analogicus/lelo_gr02_sky130a/sim/BANDGAP/README.md

TB_NCM

#### Transient analysis (tran)

Check transient operation

|**Name**|**Parameter**|**Description**| |**Min**|**Typ**|**Max**| Unit|
|:---|:---|:---|---:|:---:|:---:|:---:| ---:|
|**Current proportial to temperature, offset at zero celsius**|**iptat\_intercept** || **Spec**  | **0.050** | **0.000** | **10.000** | **uA** |
| | | |<a href='results/tran_Sch_typical.html'>Sch_typ</a>| | 1.775 |  | |
| | | |<a href='results/tran_Sch_etc.html'>Sch_etc</a>|2.120 | 2.433 | 2.816 | |
| | | |<a href='results/tran_Sch_mc.html'>Sch_3std</a>|0.439 | 2.578 | 4.717 | |
| | | |<a href='results/tran_Lay_typical.html'>Lay_typ</a>| | 2.417 |  | |
| | | |<a href='results/tran_Lay_etc.html'>Lay_etc</a>|2.120 | 2.433 | 2.816 | |
| | | |<a href='results/tran_Lay_mc.html'>Lay_3std</a>|0.073 | 2.616 | 5.159 | |
|**Current proportial to temperature, increase per kelvin**|**iptat\_slope** || **Spec**  | **0.001** | **0.000** | **0.010** | **uA/K** |
| | | |<a href='results/tran_Sch_typical.html'>Sch_typ</a>| | 0.004 |  | |
| | | |<a href='results/tran_Sch_etc.html'>Sch_etc</a>|0.005 | 0.006 | 0.006 | |
| | | |<a href='results/tran_Sch_mc.html'>Sch_3std</a>|0.003 | 0.005 | 0.008 | |
| | | |<a href='results/tran_Lay_typical.html'>Lay_typ</a>| | 0.006 |  | |
| | | |<a href='results/tran_Lay_etc.html'>Lay_etc</a>|0.005 | 0.006 | 0.006 | |
| | | |<a href='results/tran_Lay_mc.html'>Lay_3std</a>|0.001 | 0.005 | 0.009 | |
|**Current proportial to temperature, Pearson correlation coefficient**|**iptat\_rvalue** || **Spec**  | **0.950** | **1.000** | **1.050** |  |
| | | |<a href='results/tran_Sch_typical.html'>Sch_typ</a>| | 1.000 |  | |
| | | |<a href='results/tran_Sch_etc.html'>Sch_etc</a>|1.000 | 1.000 | 1.000 | |
| | | |<a href='results/tran_Sch_mc.html'>Sch_3std</a>|1.000 | 1.000 | 1.000 | |
| | | |<a href='results/tran_Lay_typical.html'>Lay_typ</a>| | 1.000 |  | |
| | | |<a href='results/tran_Lay_etc.html'>Lay_etc</a>|1.000 | 1.000 | 1.000 | |
| | | |<a href='results/tran_Lay_mc.html'>Lay_3std</a>|<span style='color:red'>**0.346**</span> | 0.962 | <span style='color:red'>**1.578**</span> | |
|**Voltage complementary to temperature, offset at zero celsius**|**vctat\_intercept** || **Spec**  | **200.000** | **0.000** | **1200.000** | **mV** |
| | | |<a href='results/tran_Sch_typical.html'>Sch_typ</a>| | 726.295 |  | |
| | | |<a href='results/tran_Sch_etc.html'>Sch_etc</a>|749.855 | 750.484 | 751.128 | |
| | | |<a href='results/tran_Sch_mc.html'>Sch_3std</a>|732.593 | 752.841 | 773.090 | |
| | | |<a href='results/tran_Lay_typical.html'>Lay_typ</a>| | 750.436 |  | |
| | | |<a href='results/tran_Lay_etc.html'>Lay_etc</a>|749.854 | 750.484 | 751.128 | |
| | | |<a href='results/tran_Lay_mc.html'>Lay_3std</a>|721.280 | 751.140 | 780.999 | |
|**Voltage complementary to temperature, increase per kelvin**|**vctat\_slope** || **Spec**  | **-2.000** | **0.000** | **-0.500** | **mV/K** |
| | | |<a href='results/tran_Sch_typical.html'>Sch_typ</a>| | -1.861 |  | |
| | | |<a href='results/tran_Sch_etc.html'>Sch_etc</a>|-1.772 | -1.765 | -1.750 | |
| | | |<a href='results/tran_Sch_mc.html'>Sch_3std</a>|-1.780 | -1.765 | -1.750 | |
| | | |<a href='results/tran_Lay_typical.html'>Lay_typ</a>| | -1.766 |  | |
| | | |<a href='results/tran_Lay_etc.html'>Lay_etc</a>|-1.772 | -1.765 | -1.750 | |
| | | |<a href='results/tran_Lay_mc.html'>Lay_3std</a>|-1.782 | -1.765 | -1.748 | |
|**Voltage complementary to temperature, Pearson correlation coefficient**|**vctat\_rvalue** || **Spec**  | **-1.050** | **-1.000** | **-0.950** |  |
| | | |<a href='results/tran_Sch_typical.html'>Sch_typ</a>| | -1.000 |  | |
| | | |<a href='results/tran_Sch_etc.html'>Sch_etc</a>|-1.000 | -1.000 | -1.000 | |
| | | |<a href='results/tran_Sch_mc.html'>Sch_3std</a>|-1.000 | -1.000 | -1.000 | |
| | | |<a href='results/tran_Lay_typical.html'>Lay_typ</a>| | -1.000 |  | |
| | | |<a href='results/tran_Lay_etc.html'>Lay_etc</a>|-1.000 | -1.000 | -1.000 | |
| | | |<a href='results/tran_Lay_mc.html'>Lay_3std</a>|-1.000 | -1.000 | -1.000 | |
|**Active current at 25 celsius**|**i\_act\_25** || **Spec**  | **5.000** | **30.000** | **100.000** | **uA** |
| | | |<a href='results/tran_Sch_typical.html'>Sch_typ</a>| | 42.410 |  | |
| | | |<a href='results/tran_Sch_etc.html'>Sch_etc</a>|40.888 | 51.259 | 66.332 | |
| | | |<a href='results/tran_Sch_mc.html'>Sch_3std</a>|46.879 | 52.581 | 58.282 | |
| | | |<a href='results/tran_Lay_typical.html'>Lay_typ</a>| | 52.168 |  | |
| | | |<a href='results/tran_Lay_etc.html'>Lay_etc</a>|40.888 | 51.259 | 66.332 | |
| | | |<a href='results/tran_Lay_mc.html'>Lay_3std</a>|46.354 | 52.533 | 58.711 | |
|**Leakage current at 25 celsius**|**i\_leak\_25** || **Spec**  | **-0.010** | **1.000** | **1.000** | **nA** |
| | | |<a href='results/tran_Sch_typical.html'>Sch_typ</a>| | 0.477 |  | |
| | | |<a href='results/tran_Sch_etc.html'>Sch_etc</a>|-0.008 | 0.271 | 0.594 | |
| | | |<a href='results/tran_Sch_mc.html'>Sch_3std</a>|0.290 | 0.330 | 0.370 | |
| | | |<a href='results/tran_Lay_typical.html'>Lay_typ</a>| | 0.594 |  | |
| | | |<a href='results/tran_Lay_etc.html'>Lay_etc</a>|0.476 | 0.616 | <span style='color:red'>**9.031**</span> | |
| | | |<a href='results/tran_Lay_mc.html'>Lay_3std</a>|<span style='color:red'>**-0.923**</span> | 0.696 | <span style='color:red'>**2.316**</span> | |
