analogicus/lelo_gr02_sky130a/design/LELO_GR02_SKY130A/COMPARATOR.md

The comparator is used to create a strong (almost rail-to-rail swing) signal indicating which of the input signals is higher.

At it's center, a differential input pair shares a common source voltage. The current ratio through the two branches of these transistors is proportional to the input voltages.
The current mirror converts the differential current into a single-ended voltage with gain.
The node labeled TAIL sits right above a current sink that forces a set current through the differential pair, increasing gain and stability.
This total current is controlled by the bias voltage V_IB generated by the bottom left current mirror and resistor.
The two transistors around the VOUT node make up a second stage amplifier providing additional gain to improve the output swing.

Power gating is used to limit leakage current by turning off the bias voltage node and disconnecting VDD when the comparator is disabled.
As a further measure, VOUT is also pulled low when in powersaving mode, avoiding a floating gate on the output.
