analogicus/lelo_gr02_sky130a/design/LELO_GR02_SKY130A/BANDGAP_DIODE.md

Diodes implemented using NPN BJTs with an area ratio of 1:8.
