analogicus/lelo_gr02_sky130a/design/LELO_GR02_SKY130A/LELO_GR02.md

This schematic shows the complete system, which consists of a bandgap reference and an oscillator. The bandgap produces a reference voltage and a bias current, which are fed into the oscillator. The oscillator generates a clock signal that is used to drive a counter.
