analogicus/lelo_gr02_sky130a/design/LELO_GR02_SKY130A/OSCILLATOR_OPAMP.md

The same circuit as the operational amplifier used in the bandgap reference, but put it in its own file.
