analogicus/lelo_gr02_sky130a/sim/BANDGAP/results/tran_Lay_etc.md

### Summary tran_Lay_etc

For details see <a href='tran_Lay_etc.html'>tran_Lay_etc.html</a>

|**Name**|**Parameter**|**View**|**Min** | **Typ** | **Max**|
|:---|:---|:---:|:---:|:---:|:---:|
|Current proportial to temperature, offset at zero celsius|iptat\_intercept | Spec | 0.050 uA |  | 10.000 uA |
| | | ('Lay',)|1.558 uA | 1.796 uA | 2.064 uA |
|Current proportial to temperature, increase per kelvin|iptat\_slope | Spec | 0.001 uA/K |  | 0.010 uA/K |
| | | ('Lay',)|0.002 uA/K | 0.004 uA/K | 0.004 uA/K |
|Current proportial to temperature, Pearson correlation coefficient|iptat\_rvalue | Spec | 0.950  | 1.000  | 1.050  |
| | | ('Lay',)|0.781  | 1.000  | 1.000  |
|Voltage complementary to temperature, offset at zero celsius|vctat\_intercept | Spec | 200.000 mV |  | 1200.000 mV |
| | | ('Lay',)|725.680 mV | 726.670 mV | 728.541 mV |
|Voltage complementary to temperature, increase per kelvin|vctat\_slope | Spec | -2.000 mV/K |  | -0.500 mV/K |
| | | ('Lay',)|-2.051 mV/K | -1.863 mV/K | -1.845 mV/K |
|Voltage complementary to temperature, Pearson correlation coefficient|vctat\_rvalue | Spec | -1.050  | -1.000  | -0.950  |
| | | ('Lay',)|-1.000  | -1.000  | -0.999  |
|Active current at 25 celsius|i\_act\_25 | Spec | 5.000 uA | 30.000 uA | 100.000 uA |
| | | ('Lay',)|33.268 uA | 42.421 uA | 54.251 uA |
|Leakage current at 25 celsius|i\_leak\_25 | Spec | -0.010 nA | 1.000 nA | 1.000 nA |
| | | ('Lay',)|0.342 nA | 0.825 nA | 0.993 nA |
