analogicus/lelo_gr02_sky130a/sim/BANDGAP/results/tran_Lay_mc.md

### Summary tran_Lay_mc

For details see <a href='tran_Lay_mc.html'>tran_Lay_mc.html</a>

|**Name**|**Parameter**|**View**|**Min** | **Typ** | **Max**|
|:---|:---|:---:|:---:|:---:|:---:|
|Current proportial to temperature, offset at zero celsius|iptat\_intercept | Spec | 0.050 uA |  | 10.000 uA |
| | | ('Lay',)|0.881 uA | 1.663 uA | 3.072 uA |
|Current proportial to temperature, increase per kelvin|iptat\_slope | Spec | 0.001 uA/K |  | 0.010 uA/K |
| | | ('Lay',)|0.000 uA/K | 0.004 uA/K | 0.006 uA/K |
|Current proportial to temperature, Pearson correlation coefficient|iptat\_rvalue | Spec | 0.950  | 1.000  | 1.050  |
| | | ('Lay',)|0.970  | 1.000  | 1.000  |
|Voltage complementary to temperature, offset at zero celsius|vctat\_intercept | Spec | 200.000 mV |  | 1200.000 mV |
| | | ('Lay',)|695.739 mV | 720.930 mV | 742.996 mV |
|Voltage complementary to temperature, increase per kelvin|vctat\_slope | Spec | -2.000 mV/K |  | -0.500 mV/K |
| | | ('Lay',)|-1.902 mV/K | -1.861 mV/K | -1.835 mV/K |
|Voltage complementary to temperature, Pearson correlation coefficient|vctat\_rvalue | Spec | -1.050  | -1.000  | -0.950  |
| | | ('Lay',)|-1.000  | -1.000  | -0.999  |
|Active current at 25 celsius|i\_act\_25 | Spec | 5.000 uA | 30.000 uA | 100.000 uA |
| | | ('Lay',)|39.207 uA | 42.246 uA | 44.743 uA |
|Leakage current at 25 celsius|i\_leak\_25 | Spec | -0.010 nA | 1.000 nA | 1.000 nA |
| | | ('Lay',)|0.931 nA | 0.954 nA | 0.963 nA |
