analogicus/lelo_gr02_sky130a/sim/BANDGAP/results/tran_Sch_mc.md

### Summary tran_Sch_mc

For details see <a href='tran_Sch_mc.html'>tran_Sch_mc.html</a>

|**Name**|**Parameter**|**View**|**Min** | **Typ** | **Max**|
|:---|:---|:---:|:---:|:---:|:---:|
|Current proportial to temperature, offset at zero celsius|iptat\_intercept | Spec | 0.050 uA |  | 10.000 uA |
| | | ('Sch',)|0.771 uA | 1.567 uA | 3.401 uA |
|Current proportial to temperature, increase per kelvin|iptat\_slope | Spec | 0.001 uA/K |  | 0.010 uA/K |
| | | ('Sch',)|-0.000 uA/K | 0.004 uA/K | 0.006 uA/K |
|Current proportial to temperature, Pearson correlation coefficient|iptat\_rvalue | Spec | 0.950  | 1.000  | 1.050  |
| | | ('Sch',)|-0.934  | 1.000  | 1.000  |
|Voltage complementary to temperature, offset at zero celsius|vctat\_intercept | Spec | 200.000 mV |  | 1200.000 mV |
| | | ('Sch',)|704.310 mV | 727.034 mV | 742.900 mV |
|Voltage complementary to temperature, increase per kelvin|vctat\_slope | Spec | -2.000 mV/K |  | -0.500 mV/K |
| | | ('Sch',)|-1.884 mV/K | -1.862 mV/K | -1.823 mV/K |
|Voltage complementary to temperature, Pearson correlation coefficient|vctat\_rvalue | Spec | -1.050  | -1.000  | -0.950  |
| | | ('Sch',)|-1.000  | -1.000  | -1.000  |
|Active current at 25 celsius|i\_act\_25 | Spec | 5.000 uA | 30.000 uA | 100.000 uA |
| | | ('Sch',)|39.106 uA | 42.689 uA | 45.836 uA |
|Leakage current at 25 celsius|i\_leak\_25 | Spec | -0.010 nA | 1.000 nA | 1.000 nA |
| | | ('Sch',)|0.053 nA | 0.378 nA | 0.455 nA |
