analogicus/lelo_gr02_sky130a/sim/LELO_GR02/results/tran_Lay_typical.md

### Summary tran_Lay_typical

For details see <a href='tran_Lay_typical.html'>tran_Lay_typical.html</a>

|**Name**|**Parameter**|**View**|**Min** | **Typ** | **Max**|
|:---|:---|:---:|:---:|:---:|:---:|
|Oscillation frequency, offset at zero celsius|freq\_intercept | Spec | 1.000 MHz |  | 10.000 MHz |
| | | ('Lay',)|1.517 MHz | 1.517 MHz | 1.517 MHz |
|Oscillation frequency, increase per kelvin|freq\_slope | Spec | 0.005 MHz |  | 0.050 MHz |
| | | ('Lay',)|0.007 MHz | 0.007 MHz | 0.007 MHz |
|Oscillation frequency, Pearson correlation coefficient|freq\_rvalue | Spec | 0.950  | 1.000  | 1.050  |
| | | ('Lay',)|1.000  | 1.000  | 1.000  |
|Maximum error from straight line, relative to full scale|freq\_max\_abs\_err\_per\_fs | Spec |  |  | 1.010  |
| | | ('Lay',)|0.004  | 0.004  | 0.004  |
|Active current at 25 celsius|i\_act\_25 | Spec | 5.000 uA | 30.000 uA | 100.000 uA |
| | | ('Lay',)|57.279 uA | 57.279 uA | 57.279 uA |
|Leakage current at 25 celsius|i\_leak\_25 | Spec | 0.100 nA | 1.000 nA | 1.000 nA |
| | | ('Lay',)|0.830 nA | 0.830 nA | 0.830 nA |
