analogicus/lelo_gr02_sky130a/sim/LELO_GR02/results/tran_Lay_etc.md

### Summary tran_Lay_etc

For details see <a href='tran_Lay_etc.html'>tran_Lay_etc.html</a>

|**Name**|**Parameter**|**View**|**Min** | **Typ** | **Max**|
|:---|:---|:---:|:---:|:---:|:---:|
|Oscillation frequency, offset at zero celsius|freq\_intercept | Spec | 1.000 MHz |  | 10.000 MHz |
| | | ('Lay',)|1.191 MHz | 1.522 MHz | 1.995 MHz |
|Oscillation frequency, increase per kelvin|freq\_slope | Spec | 0.005 MHz |  | 0.050 MHz |
| | | ('Lay',)|0.006 MHz | 0.007 MHz | 0.010 MHz |
|Oscillation frequency, Pearson correlation coefficient|freq\_rvalue | Spec | 0.950  | 1.000  | 1.050  |
| | | ('Lay',)|0.991  | 1.000  | 1.000  |
|Maximum error from straight line, relative to full scale|freq\_max\_abs\_err\_per\_fs | Spec |  |  | 1.010  |
| | | ('Lay',)|0.001  | 0.004  | 0.083  |
|Active current at 25 celsius|i\_act\_25 | Spec | 5.000 uA | 30.000 uA | 100.000 uA |
| | | ('Lay',)|44.720 uA | 57.283 uA | 73.833 uA |
|Leakage current at 25 celsius|i\_leak\_25 | Spec | 0.100 nA | 1.000 nA | 1.000 nA |
| | | ('Lay',)|0.372 nA | 4.406 nA | 34.825 nA |
