analogicus/lelo_gr02_sky130a/sim/LELO_GR02/results/tran_Sch_etc.md

### Summary tran_Sch_etc

For details see <a href='tran_Sch_etc.html'>tran_Sch_etc.html</a>

|**Name**|**Parameter**|**View**|**Min** | **Typ** | **Max**|
|:---|:---|:---:|:---:|:---:|:---:|
|Oscillation frequency, offset at zero celsius|freq\_intercept | Spec | 1.000 MHz |  | 10.000 MHz |
| | | ('Sch',)|1.448 MHz | 1.860 MHz | 2.610 MHz |
|Oscillation frequency, increase per kelvin|freq\_slope | Spec | 0.005 MHz |  | 0.050 MHz |
| | | ('Sch',)|0.006 MHz | 0.008 MHz | 0.012 MHz |
|Oscillation frequency, Pearson correlation coefficient|freq\_rvalue | Spec | 0.950  | 1.000  | 1.050  |
| | | ('Sch',)|0.931  | 0.957  | 1.000  |
|Maximum error from straight line, relative to full scale|freq\_max\_abs\_err\_per\_fs | Spec |  |  | 1.010  |
| | | ('Sch',)|0.007  | 0.161  | 0.319  |
|Active current at 25 celsius|i\_act\_25 | Spec | 5.000 uA | 30.000 uA | 100.000 uA |
| | | ('Sch',)|44.444 uA | 56.864 uA | 73.266 uA |
|Leakage current at 25 celsius|i\_leak\_25 | Spec | 0.100 nA | 1.000 nA | 1.000 nA |
| | | ('Sch',)|0.717 nA | 5.090 nA | 35.190 nA |
