analogicus/lelo_gr02_sky130a/sim/LELO_GR02/results/tran_Sch_mc.md

### Summary tran_Sch_mc

For details see <a href='tran_Sch_mc.html'>tran_Sch_mc.html</a>

|**Name**|**Parameter**|**View**|**Min** | **Typ** | **Max**|
|:---|:---|:---:|:---:|:---:|:---:|
|Oscillation frequency, offset at zero celsius|freq\_intercept | Spec | 1.000 MHz |  | 10.000 MHz |
| | | ('Sch',)|0.860 MHz | 1.669 MHz | 3.448 MHz |
|Oscillation frequency, increase per kelvin|freq\_slope | Spec | 0.005 MHz |  | 0.050 MHz |
| | | ('Sch',)|0.001 MHz | 0.007 MHz | 0.013 MHz |
|Oscillation frequency, Pearson correlation coefficient|freq\_rvalue | Spec | 0.950  | 1.000  | 1.050  |
| | | ('Sch',)|0.057  | 0.963  | 1.000  |
|Maximum error from straight line, relative to full scale|freq\_max\_abs\_err\_per\_fs | Spec |  |  | 1.010  |
| | | ('Sch',)|0.001  | 0.155  | 0.655  |
|Active current at 25 celsius|i\_act\_25 | Spec | 5.000 uA | 30.000 uA | 100.000 uA |
| | | ('Sch',)|52.371 uA | 57.187 uA | 60.969 uA |
|Leakage current at 25 celsius|i\_leak\_25 | Spec | 0.100 nA | 1.000 nA | 1.000 nA |
| | | ('Sch',)|0.788 nA | 1.404 nA | 2.352 nA |
