analogicus/lelo_gr02_sky130a/sim/BANDGAP/results/tran_Lay_etc.csv

 | iptat_intercept | iptat_slope | iptat_rvalue | vctat_intercept | vctat_slope | vctat_rvalue | i_act_25 | i_leak_25 | name | type | time | OK
0 | 1.821192955399061 | 0.003730845539906105 | 0.9996867191494946 | 726.3388014084508 | -1.8593876458752516 | -0.9999756158092287 | 42.94858 | 0.9010644000000001 | tran_LayGtKfsTlVh | Lay | Sun Apr 26 10:56:58 2026 | True
1 | 1.770146199530516 | 0.0015536494299128103 | 0.7808118505888447 | 728.5408977699531 | -2.0506455700871897 | -0.9987869739965017 | 48.720690000000005 | 0.8262835000000001 | tran_LayGtKsfTlVh | Lay | Sun Apr 26 10:56:58 2026 | False
2 | 2.053441311032863 | 0.004309110228034876 | 0.9996268385322192 | 725.6795255868544 | -1.8670175519785386 | -0.9999753699290204 | 54.25069 | 0.9930879999999999 | tran_LayGtKffTlVh | Lay | Sun Apr 26 10:56:58 2026 | True
3 | 1.557571064553991 | 0.0037513961435278343 | 0.999479189280674 | 726.9933434272299 | -1.8453422468142184 | -0.9999721735532245 | 39.00937 | 0.8121331 | tran_LayGtKssTlVh | Lay | Sun Apr 26 10:56:58 2026 | True
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
