analogicus/lelo_gr02_sky130a/sim/BANDGAP/results/tran_Lay_mc.csv

 | iptat_intercept | iptat_slope | iptat_rvalue | vctat_intercept | vctat_slope | vctat_rvalue | i_act_25 | i_leak_25 | name | type | time | OK
0 | 1.54699305399061 | 0.00307310871898055 | 0.9998082376648083 | 724.0974122065728 | -1.87964996646546 | -0.9999770758163026 | 42.435680000000005 | 0.9550866 | tran_LayGtKttmmTtVt_29 | Lay | Sun Apr 26 11:23:41 2026 | True
1 | 0.8861308791079813 | 0.00353196530516432 | 0.9758907679648218 | 695.7389059859155 | -1.8523989235412475 | -0.9989673752152738 | 39.22145 | 0.9467780000000001 | tran_LayGtKttmmTtVt_28 | Lay | Sun Apr 26 11:23:41 2026 | True
2 | 1.006978400234742 | 0.004897943896713614 | 0.9996796207828565 | 709.2958603286386 | -1.85895452045607 | -0.9999721692795717 | 40.21997 | 0.9469278999999999 | tran_LayGtKttmmTtVt_27 | Lay | Sun Apr 26 11:23:41 2026 | True
3 | 1.9856141572769956 | 0.0036629029510395696 | 0.9998559952743645 | 729.7619536384976 | -1.8626280516431923 | -0.9999768717538443 | 43.31012 | 0.9485427 | tran_LayGtKttmmTtVt_26 | Lay | Sun Apr 26 11:23:41 2026 | True
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
