analogicus/lelo_gr02_sky130a/sim/BANDGAP/results/tran_Sch_etc.csv

 | iptat_intercept | iptat_slope | iptat_rvalue | vctat_intercept | vctat_slope | vctat_rvalue | i_act_25 | i_leak_25 | name | type | time | OK
0 | 1.8206862159814448 | 0.003737193851472134 | 0.9996446680814036 | 726.269185946433 | -1.8584887695557761 | -0.9999722021708052 | 42.948370000000004 | 0.4510533 | tran_SchGtKfsTlVh | Sch | Sat Apr 25 20:19:16 2026 | True
1 | 1.7361042187735447 | 0.004241959832178577 | 0.9996172476928437 | 726.1890964943641 | -1.8608839535536488 | -0.9999709358992501 | 48.80756 | 0.38773379999999996 | tran_SchGtKsfTlVh | Sch | Sat Apr 25 20:19:13 2026 | True
2 | 2.0528198363150194 | 0.004316645152235896 | 0.9995780984030506 | 725.6100284380494 | -1.8661242705825012 | -0.9999718903176888 | 54.25036 | 0.5117021 | tran_SchGtKffTlVh | Sch | Sat Apr 25 20:19:12 2026 | True
3 | 1.5566580810595205 | 0.003775650455747441 | 0.9996278680777384 | 726.9137476326247 | -1.8440886159164447 | -0.999970212925895 | 39.00921 | 0.4057717 | tran_SchGtKssTlVh | Sch | Sat Apr 25 20:19:09 2026 | True
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
