analogicus/lelo_gr02_sky130a/sim/BANDGAP/results/tran_Sch_mc.csv

 | iptat_intercept | iptat_slope | iptat_rvalue | vctat_intercept | vctat_slope | vctat_rvalue | i_act_25 | i_leak_25 | name | type | time | OK
0 | 1.7111320901892422 | 0.0044616630275812145 | 0.9995322335769117 | 724.7952096822324 | -1.8470966997089717 | -0.9999682728212475 | 41.3802 | 0.3733017 | tran_SchGtKttmmTtVt_29 | Sch | Sat Apr 25 20:23:26 2026 | True
1 | 1.059042751606565 | 0.004272670901596964 | 0.9997990940846765 | 707.6513674727806 | -1.8615033667695848 | -0.999969938948023 | 41.477850000000004 | 0.2743601 | tran_SchGtKttmmTtVt_28 | Sch | Sat Apr 25 20:23:25 2026 | True
2 | 1.1488375002437548 | 0.003731701791966436 | 0.9998720793765538 | 716.7653681021111 | -1.8731005584198788 | -0.9999744844832583 | 42.10474 | 0.378504 | tran_SchGtKttmmTtVt_27 | Sch | Sat Apr 25 20:23:24 2026 | True
3 | 2.1206767576635 | 0.0031532002777326365 | 0.9996713752178477 | 730.1079738946092 | -1.869141611144761 | -0.9999726624616042 | 43.93668 | 0.40683339999999996 | tran_SchGtKttmmTtVt_26 | Sch | Sat Apr 25 20:23:21 2026 | True
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
