analogicus/lelo_gr02_sky130a/(commit log)

2026-01-04 Made LELO_GR02_SKY130A
    [LELO_GR02.sch]
2026-01-22 Added default sch and lay
    [LELO_GR02.sch, tt_um_lelo_gr02_analogicus.sch]
2026-01-23 [milestone1] Add schematics and symbols for bandgaps and opamp
    [LELO_GR02.sch, bandgap.sch, bandgap_opamp.sch]
2026-01-23 [m1] Move bandgap schematics to separate directories and uppercase
    [BANDGAP.sch, BANDGAP_OPAMP.sch, LELO_GR02.sch]
2026-01-24 Add m2 and m3 folders to improve project structure
    [FSM_AND_COUNTER.sch, RELAXATION_OSCILLATOR.sch]
2026-01-29 Update BANDGAP and OPAMP schematics
    [BANDGAP.sch, BANDGAP_OPAMP.sch]
2026-01-29 First version of the bandpass circuit
    [BANDGAP.sch, BANDGAP_OPAMP.sch]
2026-01-30 Updated design
    [BANDGAP.sch, LELO_GR02.sch]
2026-02-01 Started on the testbench and made changes to the bandgap opamp circuit
    [BANDGAP.sch, BANDGAP_OPAMP.sch]
2026-02-03 First simulation of circuit
    [BANDGAP_OPAMP.sch]
2026-02-04 Updated tb and op-amp
    [BANDGAP_OPAMP.sch]
2026-02-04 Improved Op-amp circuit
    [BANDGAP_OPAMP.sch]
2026-02-05 Add BANDGAP_DIODE schematic and symbol
    [BANDGAP_DIODE.sch]
2026-02-05 [m1] switch pnps and copy temp sweep testbench (nonfunctional)
    [BANDGAP.sch, BANDGAP_DIODE.sch]
2026-02-06 Fix temp simulation
    [BANDGAP.sch]
2026-02-06 Move schematics into LELO_GR02_SKY130A directory
    [BANDGAP.sch, BANDGAP_DIODE.sch, BANDGAP_OPAMP.sch, FSM_AND_COUNTER.sch, LELO_GR02.sch, RELAXATION_OSCILLATOR.sch]
2026-02-06 Add AU opamp
    [BANDGAP.sch, BANDGAP_OPAMP.sch]
2026-02-06 Fix diode symbol
2026-02-06 Add testbench for Bandgap Opamp
    [TB_LELOGR02_BANDGAP_OPAMP.sch]
2026-02-08 Improved the opamp
    [BANDGAP_OPAMP.sch, TB_LELOGR02_BANDGAP_OPAMP.sch]
2026-02-08 Updated circuits and symbols
    [BANDGAP.sch, BANDGAP_OPAMP.sch, TB_LELOGR02_BANDGAP_OPAMP.sch]
2026-02-08 Working bandgap
    [BANDGAP.sch, BANDGAP_OPAMP.sch, TB_LELOGR02_BANDGAP_OPAMP.sch]
2026-02-08 TB for bandgap
    [LELO_GR02.sch, TB_LELOGR02_BANDGAP.sch]
2026-02-12 Update schematic file references in README
2026-02-12 Updated LELO_GR02 schematic
    [LELO_GR02.sch]
2026-02-13 Added folder for files for milestone 2
    [Oscillator.sch]
2026-02-13 Add simulation results in readme
    [tran_Sch_etc.csv, tran_Sch_mc.csv, tran_Sch_typical.csv]
2026-02-13 Remove spec from simulation results
    [tran_Sch_etc.csv, tran_Sch_mc.csv, tran_Sch_typical.csv]
2026-02-13 Fix image sizing and add simulation results
    [tran_Sch_etc.csv, tran_Sch_mc.csv, tran_Sch_typical.csv]
2026-02-13 Fix units and spec for simulation results
    [tran_Sch_etc.csv, tran_Sch_mc.csv, tran_Sch_typical.csv]
2026-02-13 Added explenation for the schematics
2026-02-13 Fixed explanation for schematics
2026-02-13 Oscillator initial commit
    [OSCILLATOR.sch]
2026-02-13 updated owner info
    [LELO_GR02.sch]
2026-02-13 Refactor README for bandgap circuit explanation
    Revised the explanation of the bandgap circuit and its components for clarity. Removed redundant sections and improved the flow of information.
2026-02-13 Update README with simulation instructions
    Added simulation commands for bandgap circuit in README.
2026-02-13 Added cboarder to all files
    [BANDGAP.sch, BANDGAP_DIODE.sch, BANDGAP_OPAMP.sch]
2026-02-13 Update README with sensor and bandgap details
    Added sections for Temperature Sensor, Bandgap, Opamp - Bandgap, and Diode - Bandgap with signal details.
2026-02-13 Add signal interface tables for sensors and circuits
2026-02-13 Remove sensor and bandgap sections from README
    Removed sections for Temperature Sensor, Bandgap, Opamp - Bandgap, and Diode - Bandgap from the README.
2026-02-13 Add oscillator circuit
    [LELO_GR02.sch, OSCILLATOR.sch]
2026-02-13 Connect oscillator circuit to bandgap and rewire powerup signals
    [BANDGAP.sch, LELO_GR02.sch, OSCILLATOR.sch]
2026-02-13 Add oscillator testbench
    [OSCILLATOR.sch, tran_Sch_typical.csv]
2026-02-20 Import LELO_GR02.sch from au/m2
    [LELO_GR02.sch]
2026-02-20 Add Iver's opamp (#4)
    * did some stuff
    * Opamp
    * Cleanup files not related to new opamp
    delete opamp2 files
    delete simulation folder in design root
    ---------
    [OPAMP_iver.sch]
2026-02-20 Fixed the opamp and bandgap symbol, and changed the old opamps to Ivers opamps
    [BANDGAP.sch, LELO_GR02.sch, OSCILLATOR.sch]
2026-02-20 Oscillator testbench parameters adjusted
    [OSCILLATOR.sch]
2026-02-20 fix powerup signal and symbols
    [BANDGAP.sch, OPAMP_iver.sch, OSCILLATOR.sch]
2026-02-20 Tweak iver opamp symbol and other simulation errors
    [LELO_GR02.sch, OPAMP_iver.sch, OSCILLATOR.sch]
2026-02-27 Oscillates now. Fix issues in symbol and testbench and get components to work nicely together. Needs tuning to actual values.
    [BANDGAP_OPAMP.sch, OSCILLATOR.sch]
2026-02-27 fix path on transistor
    [OSCILLATOR.sch]
2026-02-27 Updated BANDGAP TB
    [tran_Sch_typical.csv]
2026-02-27 Milestone 7: bandgap, opamp, oscillator updates
    Milestone 2: bandgap, opamp, oscillator updates
    [BANDGAP.sch, BANDGAP_OPAMP.sch, BANDGAP_OPAMP_old.sch, LELO_GR02.sch, OPAMP_iver.sch, OSCILLATOR_OPAMP.sch, TB_LELOGR02_BANDGAP.sch, TB_LELOGR02_OSCILLATOR.sch]
2026-02-27 Fixed errors during merge
    [BANDGAP.sch, BANDGAP_OPAMP.sch, LELO_GR02.sch, OSCILLATOR.sch]
2026-02-27 Fixed LELOGR02 symbols after Simen broke them
    [LELO_GR02.sch]
2026-02-28 Add testbench for top level This simulates different temperatures and measure oscillation frequency
2026-03-01 Improved the opamp (not the final version) and removed some old results.
    [BANDGAP.sch, BANDGAP_OPAMP.sch, LELO_GR02.sch, TB_LELOGR02_BANDGAP.sch, tran_Sch_typical.csv]
2026-03-01 Included a BANDGAP design which uses cascode current mirror
    [BANDGAP_CASCODE.sch]
2026-03-01 Made a linear bandgap
    [BANDGAP.sch, BANDGAP_OPAMP.sch, TB_LELOGR02_BANDGAP.sch, tran_Sch_typical.csv]
2026-03-01 Updated ota oscillator symbol and schematic
    [OSCILLATOR_OPAMP.sch]
2026-03-01 Fixed the polarity of the opamp
    [BANDGAP.sch, BANDGAP_OPAMP.sch, OSCILLATOR_OPAMP.sch]
2026-03-04 added power gating, working osc
    [OSCILLATOR.sch]
2026-03-04 add NMOS powergating to oscillator
    [OSCILLATOR.sch]
2026-03-05 osc and bandgap working nicely together; todo: test corners, specify target freq, measure current consumption, decrease circuit size and optimize where possible (eg gating transistor size)
    [LELO_GR02.sch, OSCILLATOR.sch, tran_Sch_typical.csv]
2026-03-05 Fix PWRUP in top level testbench (#6)
    * Add leakage current measurement and current usage updated. Fix pwrup
    * Fix parameter syntax
    * Working pwrup at least
    * Fix leakage current measure
2026-03-06 Included error plot for the bandgap circuit
    [OSCILLATOR.sch]
2026-03-06 fix simulation timestep
    [tran_Sch_typical.csv]
2026-03-06 minimalize gating transistors on oscillator
    [OSCILLATOR.sch, tran_Sch_typical.csv]
2026-03-06 Added explanation to all circuits
2026-03-06 partially minimize circuit; finish up circuit for milestone-2; run simulations for corners; fix that oscillations are inconsistent (again simply due to insufficient step resolution)
    [OSCILLATOR.sch, tran_Sch_etc.csv]
2026-03-06 Not all schematic explanations were included. This is now fixed
2026-03-06 Add simulation results
    [tran_Sch_etc.csv, tran_Sch_mc.csv, tran_Sch_typical.csv]
2026-03-06 Fix scaling and specs
    [tran_Sch_etc.csv, tran_Sch_mc.csv, tran_Sch_typical.csv]
2026-03-06 Fix leakage current spec
    [tran_Sch_etc.csv, tran_Sch_mc.csv, tran_Sch_typical.csv]
2026-03-06 Revise README with simulation observations and results
    Updated observations and results from the oscillator simulation, including frequency curves and power usage measurements.
2026-03-06 Update oscillator schematic info
2026-03-06 Add some nonzero spec to work around cicsim summary not marking values as out of spec
    [tran_Sch_etc.csv, tran_Sch_mc.csv, tran_Sch_typical.csv]
2026-03-13 Previously, leakage current was measured at 70°C for a long simulation time. This was changed to 25C and 1µs. Result names in the results folder were also updated.
    [tran_Sch_typical.csv]
2026-03-13 Import oscillator and testbench from ia/m2
    [OSCILLATOR.sch, TB_LELOGR02.sch]
2026-03-13 Import OPAMP_iver schematic and symbol from ia/m2
    [OPAMP_iver.sch]
2026-03-13 Added leakage current and active current measurement for the Bandgap. TODO: Improve Python plot
2026-03-14 Copy OSCILLATOR.sch from jh/m2_adjust_f to milestone-3
    [OSCILLATOR.sch]
2026-03-14 Copy OSCILLATOR.sch from main to milestone-3 (oscillator from jh/m3 did not work)
    [OSCILLATOR.sch]
2026-03-14 Revert "Copy OSCILLATOR.sch from main to milestone-3 (oscillator from jh/m3 did not work)"
    This reverts commit 697c7b59b068fc7bcde9ab815210a0b39c0c17ae.
    [OSCILLATOR.sch]
2026-03-14 Reduced the leakage current by forcing the output of the ota to be 0 while PWRUP_N is high
    [BANDGAP.sch, BANDGAP_OPAMP.sch]
2026-03-15 Added plots for active current and leakage current of the bandgap
2026-03-16 Changed when leakage current is measured after talking with Carsten
    [tran_Sch_typical.csv]
2026-03-16 Changed capacitor sizes in the BANDGAP and the ota to reduce leakage current. We are now in spec
    [BANDGAP.sch, BANDGAP_OPAMP.sch, tran_Sch_typical.csv]
2026-03-19 System meets all specs at typical corner. Changed powergating in bandgap
    [BANDGAP.sch, BANDGAP_OPAMP.sch, LELO_GR02.sch, OPAMP_iver.sch, OSCILLATOR.sch, TB_LELOGR02.sch]
2026-03-19 Made the bandgap more step
    [BANDGAP.sch, LELO_GR02.sch]
2026-03-20 impelment sensor;
    standardize module interface names;
    create sensor module, combining counter and fsm;
    create tb for sensor module;
    add makefile for verilog simulation commands;
    fix issue in fsm: caputred data would only be valid a cycle after the completed signal was asserted. this was too late for the rest of the system. now, the completed signal signals valid data on the counter output;
    [counter.v, fsm.v, sensor.v, sensor_tb.v]
2026-03-20 replace wire with logic
    [counter.v, fsm.v, sensor.v]
2026-03-21 stop counter rollover by adding clamping at max value; add counter testbench for verification
2026-03-23 Final circuit 0.35nA leakage
    [BANDGAP.sch, COMPARATOR.sch, OSCILLATOR.sch]
2026-03-27 Improved the Oscillator schematic
    [OSCILLATOR.sch]
2026-03-30 Imported the layout of BANDGAP_OPAMP.sch from branch au/m4
    [BANDGAP.sch, BANDGAP_OPAMP.sch, tran_Sch_typical.csv]
2026-04-08 Bandgap diode
2026-04-10 3x3 diode
2026-04-10 WIP: BANDGAP layout mostly finished Still some lvs problem due to diodes
    rename diode vss to c
    [BANDGAP_DIODE.sch]
2026-04-14 Made a CELL for the flip-flip, to easier find the pins. Passes LVS
    [Test_FF.sch]
2026-04-15 added config to generate digital layout using libre lane
    [pin_order.cfg]
2026-04-15 Oscillator circuit to be improved
    [OSCILLATOR.sch]
2026-04-15 lower oscillator leakage by adding gating NMOS
    [OSCILLATOR.sch, tran_Sch_typical.csv]
2026-04-16 Used the impoved design by Jonas and added NMOS powergating inside the comparator instead of having them outside. Reduced the leakage bellow 1nA
    [COMPARATOR.sch, OSCILLATOR.sch]
2026-04-16 Oscillator with 0.297nA leakage
    [COMPARATOR.sch, OSCILLATOR.sch]
2026-04-16 Final Oscillator and Comparator sch (0.255nA)
    [COMPARATOR.sch]
2026-04-17 Update bandgap simulation results
    [tran_Lay_etc.csv, tran_Lay_mc.csv, tran_Lay_typical.csv, tran_Sch_etc.csv, tran_Sch_mc.csv, tran_Sch_typical.csv]
2026-04-17 Add digital layout
    [pin_order.cfg]
2026-04-17 Bandgap diode checkpoint
2026-04-17 Added results to schematics, made CELL=LELO_GR02 in Makefile, fixed README.md and made simulation show plots
    [BANDGAP.sch, BANDGAP_OPAMP.sch, COMPARATOR.sch, OSCILLATOR.sch, tran_Sch_typical.csv]
2026-04-24 Fixed DRC errors, but we have high leakage
    [BANDGAP.sch]
2026-04-25 Fixed the leakage current
    [BANDGAP.sch, BANDGAP_OPAMP.sch, LELO_GR02.sch, tran_Sch_etc.csv, tran_Sch_mc.csv, tran_Sch_typical.csv]
2026-04-26 Updated all the simulations (Ardit)
    [tran_Lay_etc.csv, tran_Lay_mc.csv, tran_Lay_typical.csv, tran_Sch_typical.csv]
2026-04-29 Increased the run time of simultions to provide more accurate MC simulation
    [tran_Lay_etc.csv, tran_Lay_mc.csv, tran_Lay_typical.csv]
2026-04-29 changed leakage sim length
    [tran_Lay_typical.csv, tran_Sch_etc.csv, tran_Sch_mc.csv]
2026-04-30 add testbench printing averaged comparator delay
2026-04-30 Typical, MC and ETC simulations results with 30us simulation time
    [TB_LELOGR02_BANDGAP_OPAMP.sch, tran_Lay_etc.csv, tran_Lay_mc.csv, tran_Lay_typical.csv]
2026-04-30 Made summary
    [tran_Lay_typical.csv]
